conradkirschner/Feuerwehr-Tracking-system/esp32/README.MD

# Dieser Ordner beinhaltet alle ESP32 Module  
- Ändere die Source Code Konfiguration, bevor du die Module flashst
