conradkirschner/Feuerwehr-Tracking-system/(commit log)

2020-11-08 first version of the temperature and pressure sensor
2021-02-11 Sample password file
2021-02-26 Update wifi_bmp280_mqtt_htw.ino
    - es muss nur noch 1x die clientID geändert werden
    - der ESP baut nun erneut die Wifi Verbindung auf, wenn das Wifi nicht erreichbar war
2021-03-12 ESP32 fuer Batteriemessung vollstaendig. Wifi-Verbindung wird aufgebaut. MQTT-Nachrichten werden uebermittelt.
2021-03-12 Anpassung der Verbindung
2021-03-12 alte Dateien aus dem Repository entfernt und nur noch die funktionierende Datei hinterlegt.
2021-03-12 C-Script fuer funktionierende Spannungsmessung und versenden von den Spannungswerten ueber WIFI/MQTT Verbindung
2021-12-10 Update Batteriemessung auf Version 0.4
    feat: Debug-Funktion hinzugefuegt
    dev: neue Eichungswerte fuer die zusaetzliche Vorsicherungsschaltung
